axw13/wifi-keyboard-bridge/firmware/esp8266/secrets.example.h

#pragma once
#define WIFI_SSID "YOUR_WIFI_NAME"
#define WIFI_PASSWORD "YOUR_WIFI_PASSWORD"
#define SHARED_TOKEN "REPLACE_WITH_LONG_RANDOM_SECRET"
// Optional: uncomment if the bridge still stalls; some routers handle ESP8266 802.11n poorly.
// #define WIFI_FORCE_11G
