axw13/wifi-keyboard-bridge/(commit log)

2026-10-16 Add initial firmware/pico/code.py
2026-10-16 Add initial docs/wiring.md
2026-10-16 Tune latency: firmware/pico/code.py
2026-10-16 Tune latency: docs/wiring.md
2026-10-16 Fix CircuitPython keyboard lookup without next default argument
    [code.py]
2026-10-16 Preserve local modifier key releases when switching to remote
2026-10-16 Forward authenticated mouse state and movement frames over UART
2026-10-16 Add USB HID mouse reports to Pico alongside keyboard
2026-10-16 Add low-level mouse hook for relative movement buttons and wheel
2026-10-16 Expose independent mouse shortcut and linked-switch toggle in settings
2026-10-16 Fail back to local for both devices on Wi-Fi disconnection
2026-10-16 Release mouse buttons as well as keyboard on bridge timeout/disconnect
2026-10-16 Document mouse hotkeys, linked switching and device update requirements
2026-10-16 Rate limit and aggregate mouse movement at 60 Hz on network sender
2026-10-16 Use deterministic 250ms keyboard keepalive alongside bounded 60Hz mouse movement
2026-10-16 Use mouse hook for button suppression, not pointer-coordinate deltas
2026-10-16 Document evenly paced mouse motion and recommended 60Hz baseline
2026-10-16 Add benchmark button and latency percentile readout to settings
2026-10-16 Document benchmark scope and future Pico return UART telemetry
2026-10-16 Expose authenticated ESP8266 Wi-Fi RSSI, heap and UART-forward counters
2026-10-16 Add opt-in current-user Windows startup registration
2026-10-16 Define staged delivery and verification for full v2 roadmap
2026-10-16 Add optional Pico UART diagnostic acknowledgment without changing HID input path
2026-10-16 Implement bounded NodeMCU UART0 Pico diagnostic RTT request and response
2026-10-16 Track optional Pico UART diagnostic probe response and elapsed time in Windows transport
2026-10-16 Display optional Pico UART round-trip diagnostics and include in export
2026-10-16 Document experimental UART return line and warn of NodeMCU USB-UART electrical contention
2026-10-16 Use electrically separate Pico GP4 diagnostic UART TX instead of shared UART0 RX return
2026-10-16 Receive Pico diagnostic ACK on separate NodeMCU GPIO14 software UART at 38400 baud
2026-10-16 Document safe separate Pico GP4 to NodeMCU D5 diagnostic return wiring
2026-10-16 Document optional two-UART Pico diagnostic probe protocol and limitations
2026-10-16 Correct Pico diagnostic acknowledgment newline framing
    [code.py]
2026-10-16 Use escaped newline in Pico diagnostic ACK literal
2026-10-16 Update v2 plan to reflect experimental isolated Pico UART diagnostics
2026-10-16 Use Pico GP0 UART TX for diagnostic acknowledgments at 115200 baud
2026-10-16 Allow optional HID-only storage-free Pico USB startup
2026-10-16 Document auto configuration, optional Pico mass-storage hiding, and recovery
2026-10-16 Pass lock keys to local Windows LEDs while forwarding Num/Scroll/Caps Lock to remote HID
2026-10-16 Clarify anti-idle timer interval in settings
2026-10-16 Send anti-idle HID movement to remote Pico instead of local Windows cursor
2026-10-16 Document tested Pico VBUS-to-NodeMCU VIN single-USB wiring and safeguards
2026-10-19 Document persistent NodeMCU-powered anti-idle and firmware requirement
2026-10-19 Add recordable shortcut controls and editable typed switch sequence
2026-10-19 Recognize configurable modifier shortcuts and typed two-device switch sequence
2026-10-19 Defer sequence mode switching until after triggering key is processed
2026-10-19 Document customizable shortcut recording and typed switching sequence
2026-10-19 Ignore auto-repeat keydowns when detecting typed switch sequence
2026-10-27 Add failure diagnostics logging and fix input lag sources
    Windows client
    - Background, rotating diagnostic log (4 x 2 MiB): connect/auth timing,
    disconnect reasons with session duration, Wi-Fi stalls, 60 s link
    summaries, firmware DIAG counters, mode switches with reasons, power and
    network events, and unhandled exceptions.
    - "Open log folder" in tray and Diagnostics tab; export now includes link
    stats, firmware counters, RTT history and the last 400 log lines.
    - Schedule with Stopwatch and raise timer resolution to 1 ms while
    connected; TickCount64/Task.Delay quantised pacing to 16/32 ms.
    - Send every queued frame per pass and wake immediately on key/button
    frames instead of one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
    [code.py, esp8266.ino]
2026-10-27 Hold mouse only on PC->NodeMCU backlog; log stall direction
    A late PONG alone also suppressed keepalives, so a stall on the return
    path froze the mouse and let the NodeMCU watchdog release held keys.
    - Keepalives are always sent.
    - Mouse motion is held only while Windows TCP_INFO reports more than
    200 bytes to the NodeMCU unacknowledged.
    - Each stall is classified as PC->NodeMCU (retransmits/unacked data) or
    NodeMCU->PC (reply delayed); Link line and summaries show both counts,
    TCP retransmitted bytes and RTO episodes, and time mouse was held.
    - NodeMCU DIAG reports rxgap: longest silence from the PC since the last
    DIAG (firmware 2.2).
    - Troubleshooting doc: reading stall direction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
    [esp8266.ino]
2026-10-27 Fix exit crash; confirm stall direction with NodeMCU; avoid false reconnects
    - Exit: the transport's disconnect callback could run after the tray icon
    was disposed (NullReferenceException in NotifyIcon.UpdateIcon).
    - Stall direction: Windows retransmits when only the NodeMCU's ACKs are
    lost, so TCP stats misread return-path stalls as PC->NodeMCU. After a
    stall the client now asks GAP? and the NodeMCU reports how long it went
    without data (firmware 2.3); the TCP guess is only a labelled fallback.
    - Dead-link timeout 5 s -> 10 s: a 5 s reply outage disconnected a session
    whose input was still being delivered (rxgap 495 ms).
    - Reconnect tries the saved address for 1 s before mDNS (was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
    [esp8266.ino, secrets.example.h]
2026-10-27 Protocol v3: mutual authentication and encryption for TCP and UDP
    The token is no longer sent. The client and NodeMCU prove they know it with
    HMAC-SHA256 challenge-response (the client checks the server first, so an
    impostor is refused), derive per-session keys with HKDF-SHA256, and carry
    all traffic as ChaCha20-Poly1305: TCP frames with a per-direction counter,
    UDP datagrams with the sequence number as nonce. Tampered, replayed,
    reordered or forged traffic ends the session or is dropped; failed logins
    back off. The plaintext AUTH is removed (firmware 3.0).
    Adds a test project (RFC test vectors, tamper and replay handling, an
    in-process server and live NodeMCU/Pico tests), a firmware SELFTE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
    [esp8266.ino]
2026-10-27 Add USB serial link as an alternative to Wi-Fi
    The client can send the protocol's command lines over the NodeMCU's own USB
    port. Replies come back as '#' lines on the wire the Pico also listens to, so
    the Pico firmware ignores '#' lines. USB input has priority over Wi-Fi while
    active and releases held keys after 1.5 s of silence. New client setting
    Link (wifi | usb | auto) and tests (97 checks with --device).
